coreysmccall/WeddingLEDBracelet/hardware/Bracelet/BOM_WeddingLEDBracelet_R3.csv

No. | Quantity | Comment | Designator | Value | Manufacturer Part | Manufacturer | Supplier Part | Supplier
1 | 1 | MY-2450-03 | BAT1 |  | MY-2450-03 | MYOUNG(美阳) | C2988622 | LCSC
2 | 1 | 10uF | C2 | 10uF | TAJA106K016RNJ | Kyocera AVX | C7171 | LCSC
3 | 8 | 4.7uF | C5,C6,C7,C8,C9,C10,C11,C12 | 4.7uF | CL10A475KO8NNNC | SAMSUNG(三星) | C19666 | LCSC
4 | 3 | 100nF | C13,C14,C15 | 100nF | CC0603KRX7R9BB104 | YAGEO(国巨) | C14663 | LCSC
5 | 6 | XL-2012SURC-FJ | LED1,LED2,LED3,LED4,LED5,LED6 |  | XL-2012SURC-FJ | XINGLIGHT(成兴光) | C7371909 | LCSC
6 | 2 | XL-2012UYC-FJ | LED7,LED8 |  | XL-2012UYC-FJ | XINGLIGHT(成兴光) | C7371908 | LCSC
7 | 8 | WNM2021-3/TR | Q1,Q2,Q3,Q4,Q5,Q6,Q7,Q8 |  | WNM2021-3/TR | WILLSEMI(韦尔) | C239556 | LCSC
8 | 2 | 10kΩ | R1,R2 | 10kΩ | 0603WAF1002T5E | UNI-ROYAL(厚声) | C25804 | LCSC
9 | 8 | 150Ω | R3,R6,R9,R12,R15,R18,R21,R24 | 150Ω | 0603WAF1500T5E | UNI-ROYAL(厚声) | C22808 | LCSC
10 | 1 | 100kΩ | R26 | 100kΩ | 0603WAF1003T5E | UNI-ROYAL(厚声) | C25803 | LCSC
11 | 8 | 100kΩ | R36,R37,R38,R39,R40,R41,R42,R43 | 100kΩ | 0402WGF1003TCE | UNI-ROYAL(厚声) | C25741 | LCSC
12 | 8 | 100Ω | R44,R45,R46,R47,R48,R49,R50,R51 | 100Ω | 0402WGF1000TCE | UNI-ROYAL(厚声) | C25076 | LCSC
13 | 1 | ATTINY816-MNR | U1 |  | ATTINY816-MNR | MICROCHIP(美国微芯) | C2052778 | LCSC
14 | 1 | ADXL345BCCZ-RL7 | U2 |  | ADXL345BCCZ-RL7 | ADI(亚德诺) | C9667 | LCSC
15 | 2 | FPC-1.0FX-16PWCR-H20 | U3,U4 |  | FPC-1.0FX-16PWCR-H20 | XUNPU(讯普) | C19269359 | LCSC
16 | 1 | bracelet_fingers | U5
17 | 1 | touch_heart | U6
18 | 3 | TP_1P | U8,U9,U10
