coreysmccall/WeddingLEDBracelet/PowerTests.md

# Power Tests
Tests related to power consumption using a cheap CR2450 battery ([EEMB from Amazon](https://a.co/d/5ZDkXNy)). A few batteries were tested with varying capacities between 80-100%.

## Max Current Stress Test
This test measures the maximum current stress by running [TestLEDMaxCurrent.ino](firmware/TestLEDMaxCurrent/TestLEDMaxCurrent.ino) in step mode, which turns the LEDs on one at a time in 200 ms steps until they are all on.

Using a 3.0 V bench supply, the max current drawn is ~53 mA. This aligns with the expected consumption of:

$$
(8 \times LED) \times \frac{(3V_{\text{supply}} - 2.0V_{\text{LED forward}})}{150\Omega} + (1mA_{\text{ATTINY816 @ 1MHz}}) \approx 54mA
$$

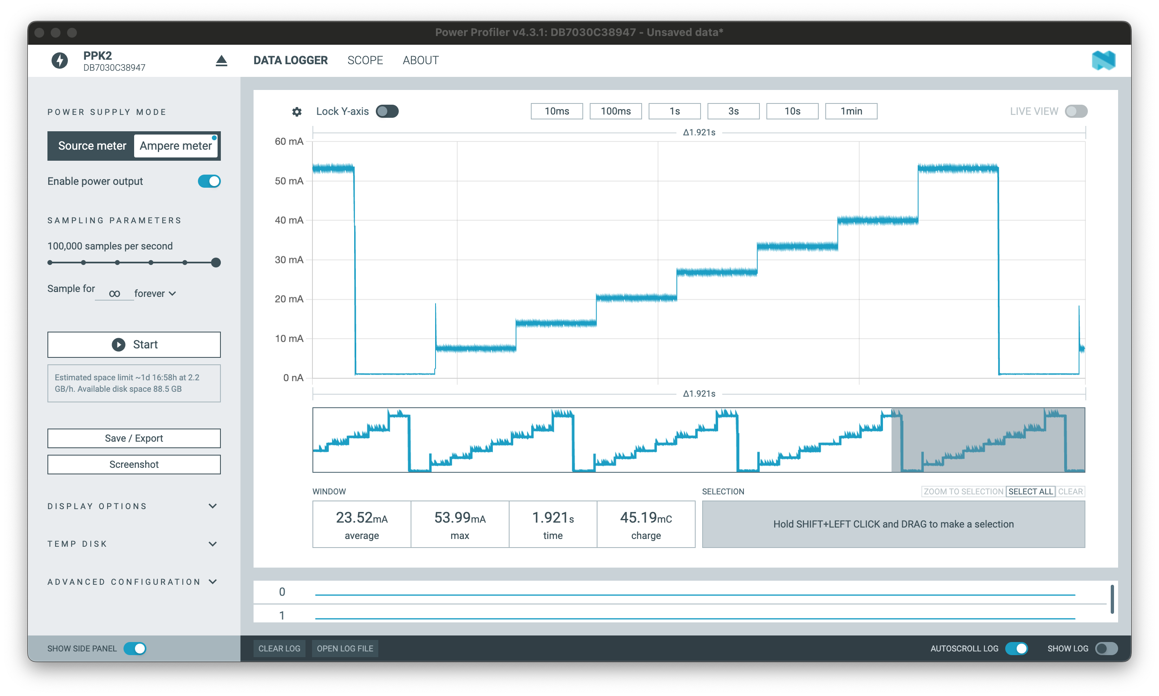
[picture p3: images/tests/PSU_LEDCurrentStep_I.png]
PSU_LEDCurrentStep_I


Using the battery, it is able to source around ~38 mA at the same maximum step, resulting in a voltage drop of about 300 mV to ~2.7 V (~8 Ω ESR):

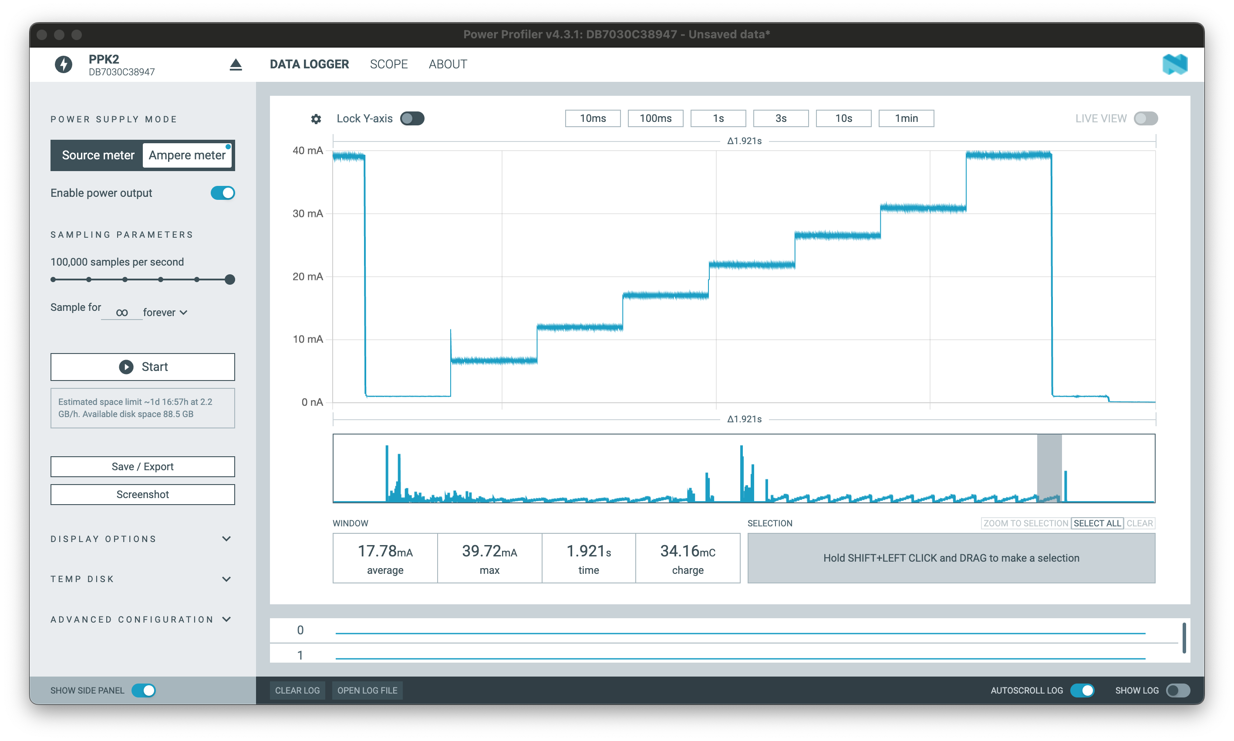
[picture p4: images/tests/EEMB_LEDCurrentStep_I.png]
EEMB_LEDCurrentStep_I
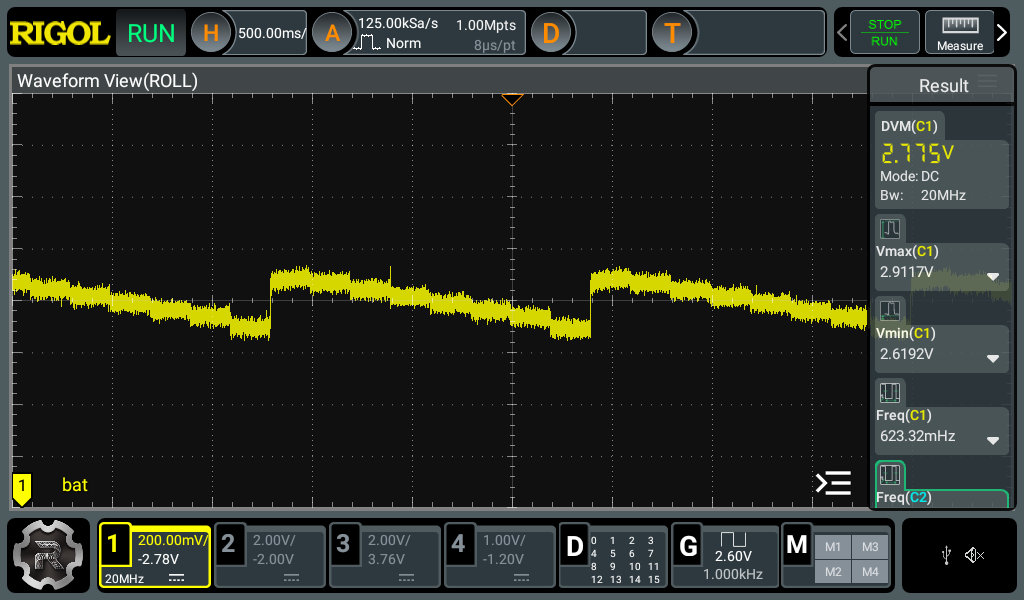
[picture p5: images/tests/EEMB_LEDCurrentStep_V.png]
EEMB_LEDCurrentStep_V
&nbsp;&nbsp;&nbsp;&nbsp;&nbsp;&nbsp;&nbsp;&nbsp;&nbsp;&nbsp;&nbsp;&nbsp;&nbsp;&nbsp;&nbsp;&nbsp;&nbsp;&nbsp;

The battery is also able to sustain >30 mA DC drain for several minutes with only slowly decreasing voltage plateauing around ~2.5V (~17 Ω ESR) after a few minutes. This test was run from [TestLEDMaxCurrent.ino](firmware/TestLEDMaxCurrent/TestLEDMaxCurrent.ino) (not in step mode):

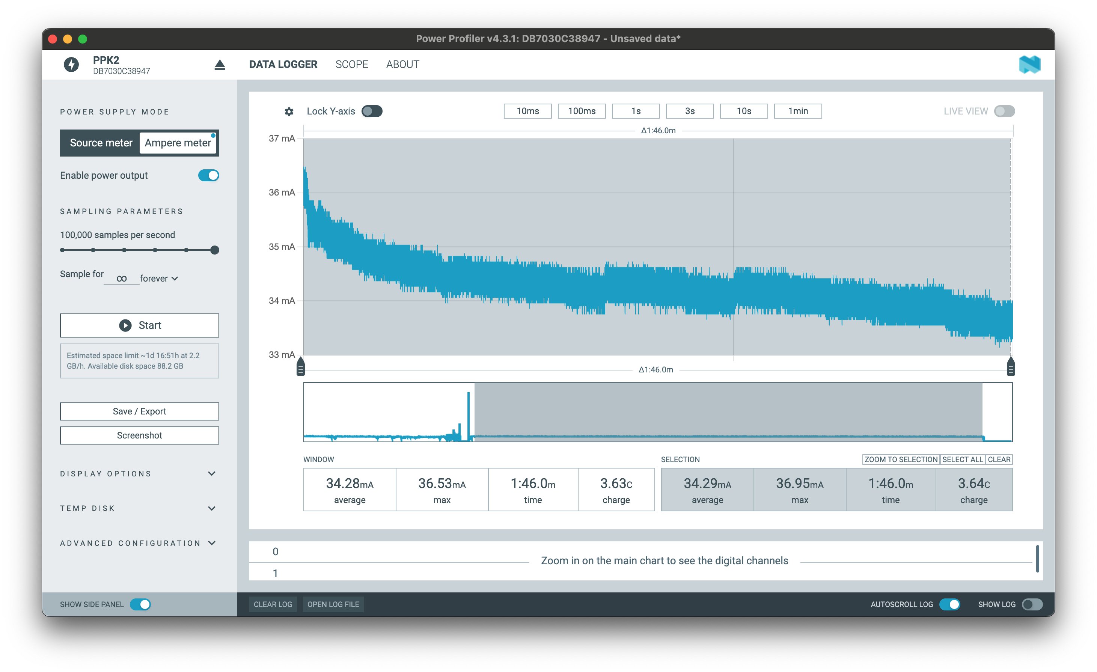
[picture p6: images/tests/EEMB_drain_I.png]
EEMB_drain_I
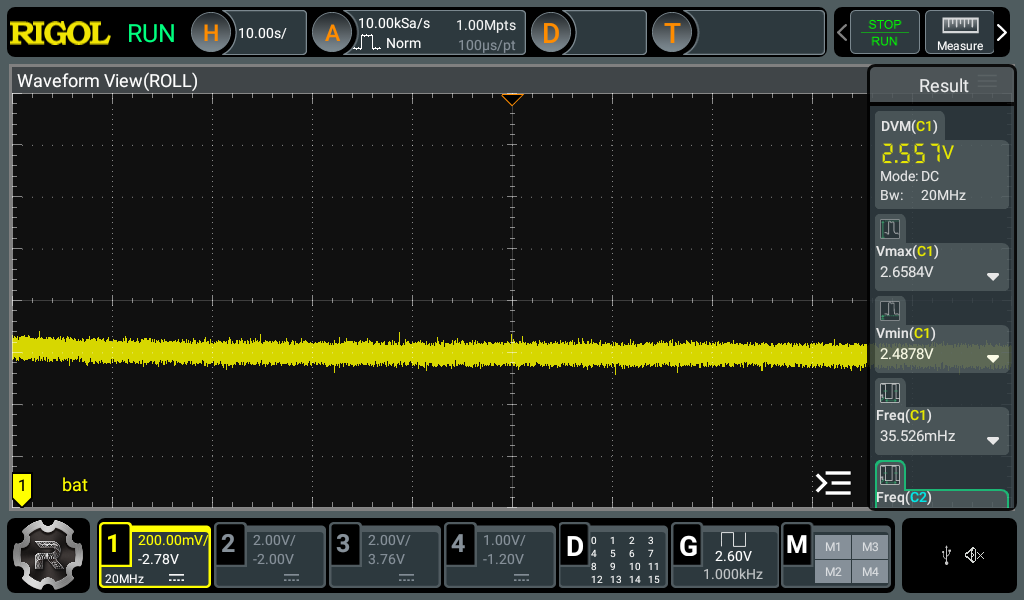
[picture p7: images/tests/EEMB_drain_V.png]
EEMB_drain_V
&nbsp;&nbsp;&nbsp;&nbsp;&nbsp;&nbsp;&nbsp;&nbsp;&nbsp;&nbsp;&nbsp;&nbsp;&nbsp;&nbsp;&nbsp;&nbsp;&nbsp;&nbsp;

## PWM Pattern Operation
The Twinkle pattern in [TestPWMs.ino](firmware/TestPWMs/TestPWMs.ino) is a good indication of a typical LED pattern with reasonable brightness (shown in the [README](README.md) gif). This pattern randomly adjusts LED brightness via PWM without any attention to phase alignment. The individual duty cycles are low, but occasionally both PWM timers align and all 8 LEDs briefly draw max current for up to the max duty cycle (~16% @ ~500 Hz = ~310 µs). 

On the bench supply, you can see the occasional max draw of ~53 mA when this occurs, agreeing with the stress test above.

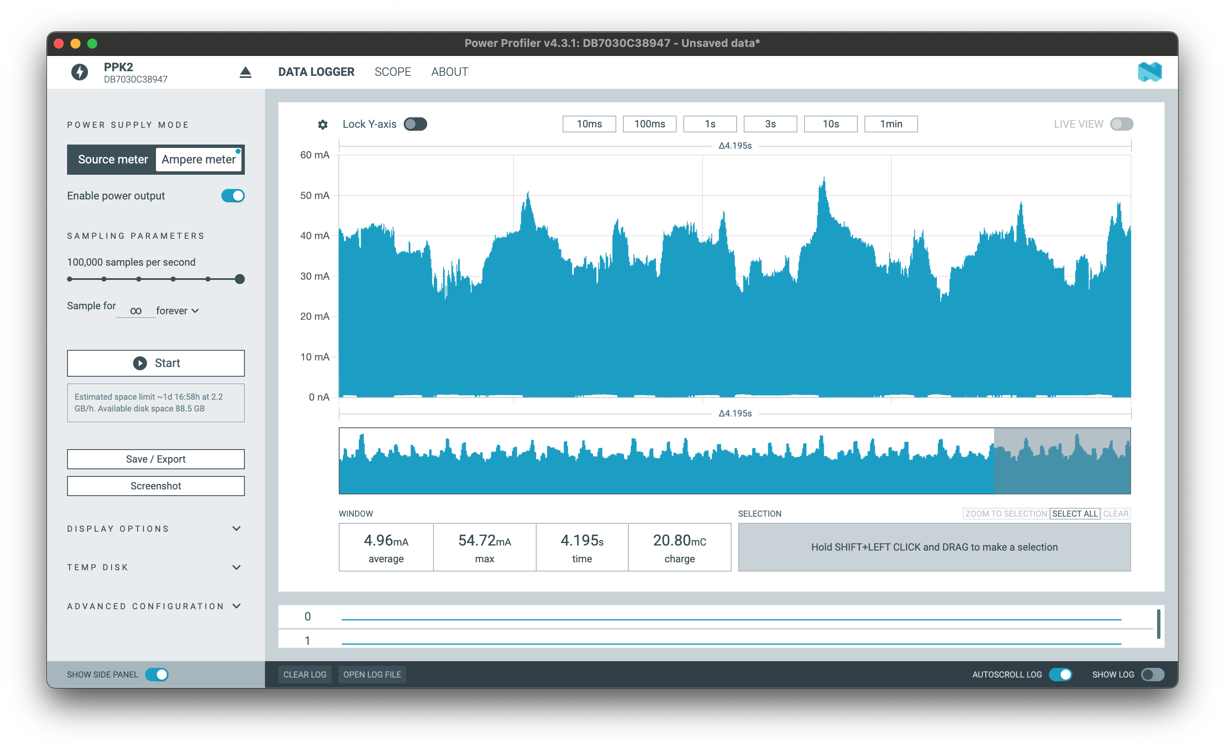
[picture p8: images/tests/PSU_testPWMs_I.png]
PSU_testPWMs_I


On the battery, the consumption also agrees with the stress test, maxing out at ~35 mA:

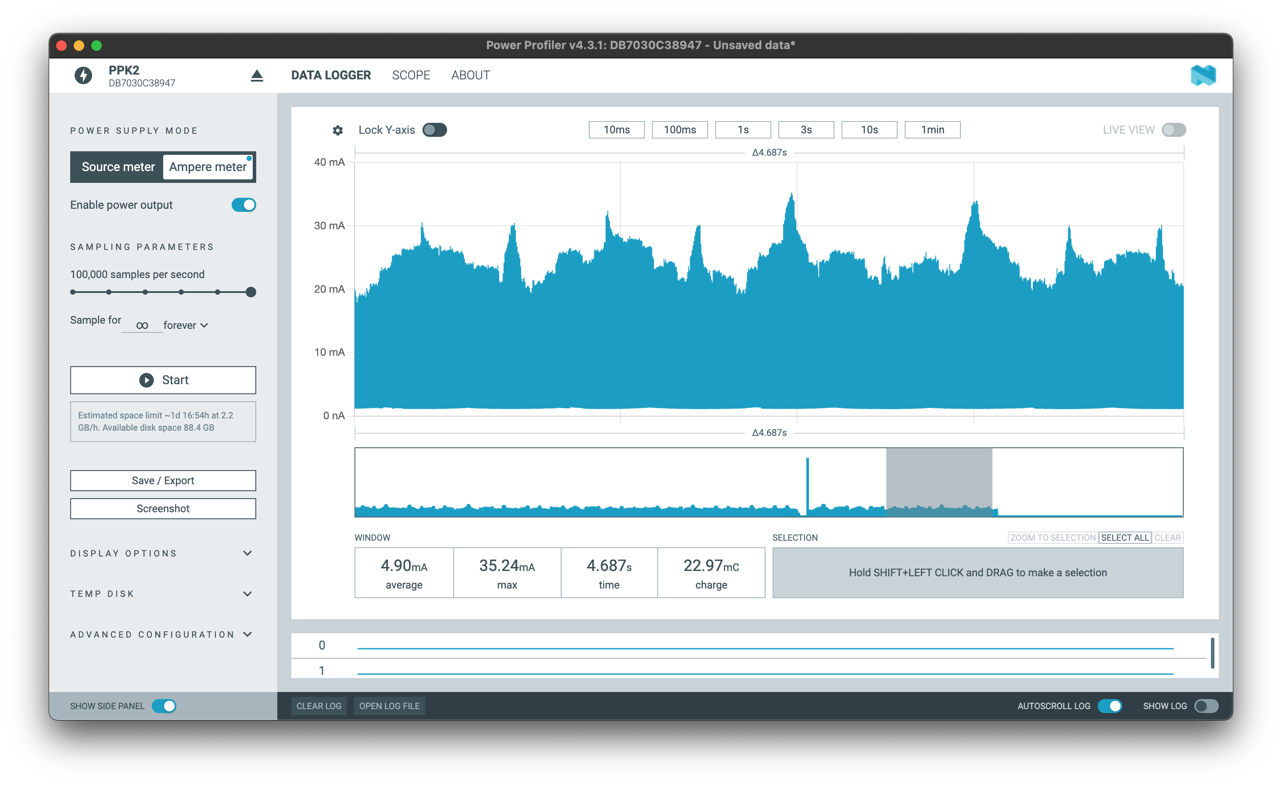
[picture p9: images/tests/EEMB_testPWMs_I.png]
EEMB_testPWMs_I
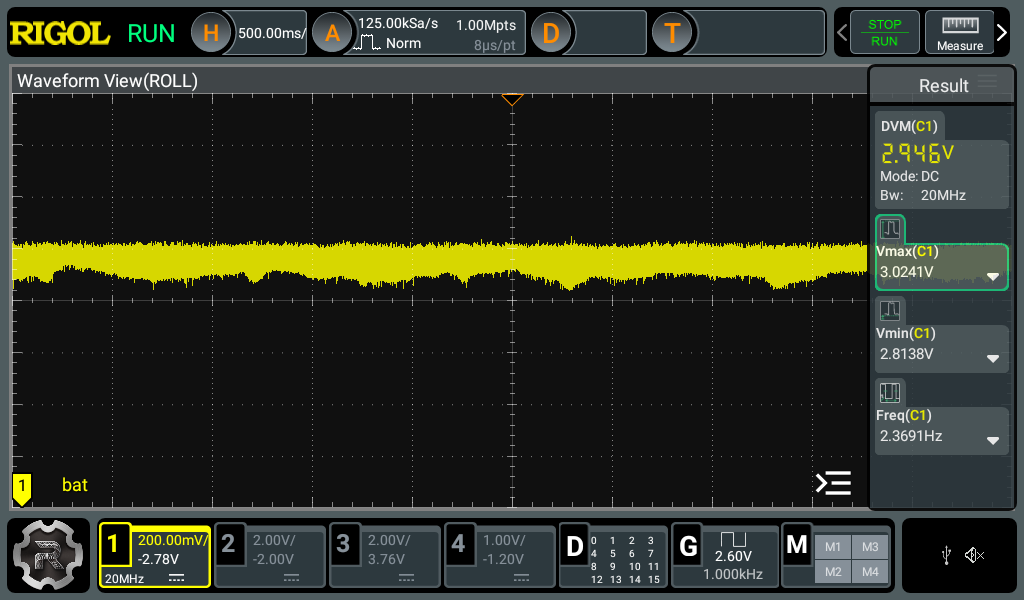
[picture p10: images/tests/EEMB_testPWMs_V.png]
EEMB_testPWMs_V
&nbsp;&nbsp;&nbsp;&nbsp;&nbsp;&nbsp;&nbsp;&nbsp;&nbsp;&nbsp;&nbsp;&nbsp;&nbsp;&nbsp;&nbsp;&nbsp;&nbsp;&nbsp;

Unlike the DC drain test, the battery voltage can now be easily maintained at its nominal 3V, as the average current is much lower and it only needs to recover from short pulses—the worst being when both PWM timers overlap like the one below:

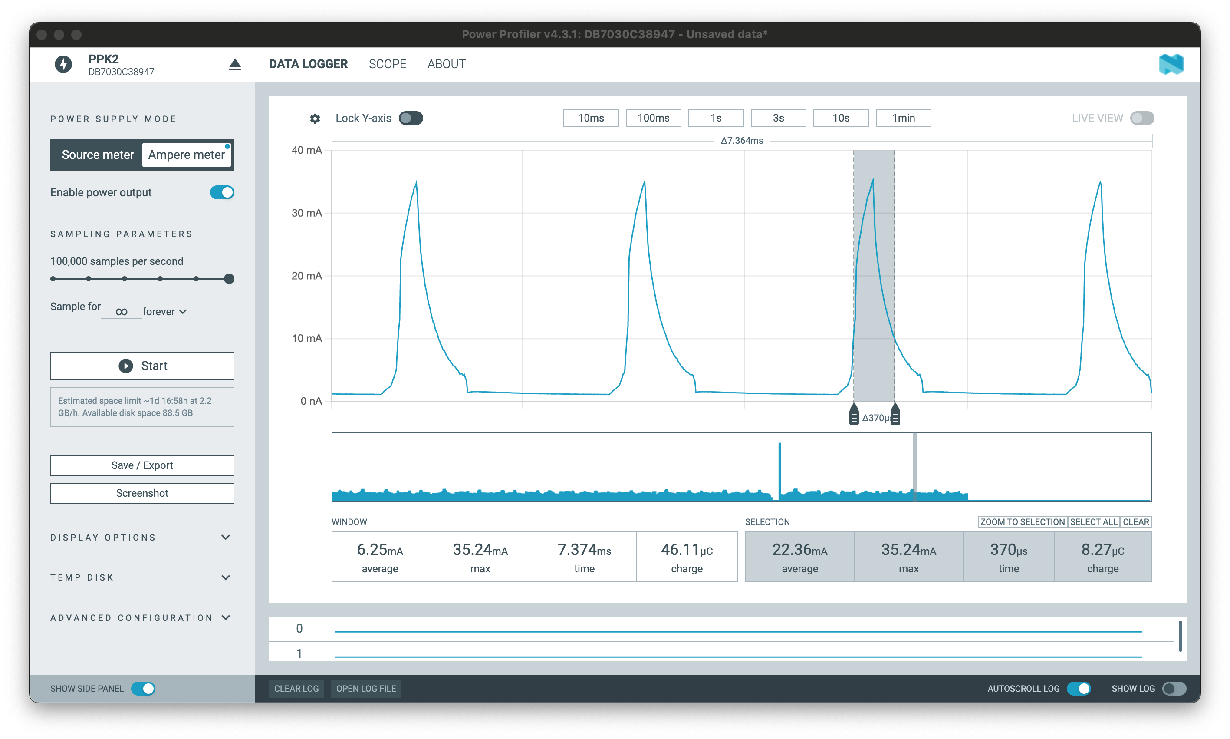
[picture p11: images/tests/EEMB_testPWMs_I_zoom.png]
EEMB_testPWMs_I_zoom


There are [4.7 µF capacitors at each of the 8x LEDs](hardware/Bracelet/Sch_WeddingLEDBracelet_R3.pdf) that may help to minimize max voltage droop of short PWM pulses as the battery ESR increases with depletion. If ESR becomes an issue, faster PWM frequencies (> 500 Hz) could be tried to better utilize these capacitors during strenuous patterns. 

## Non-LED Power Consumption
The LEDs are the main consumers of current. However, the MCU, accelerometer, and touch sensor also consume current. This can be measured from [TestHardware.ino](firmware/TestHardware/TestHardware.ino) before the LED pattern begins. This current is <1 mA with periodic spikes to 1.5 mA from the PTC (MCU touch sensor controller).

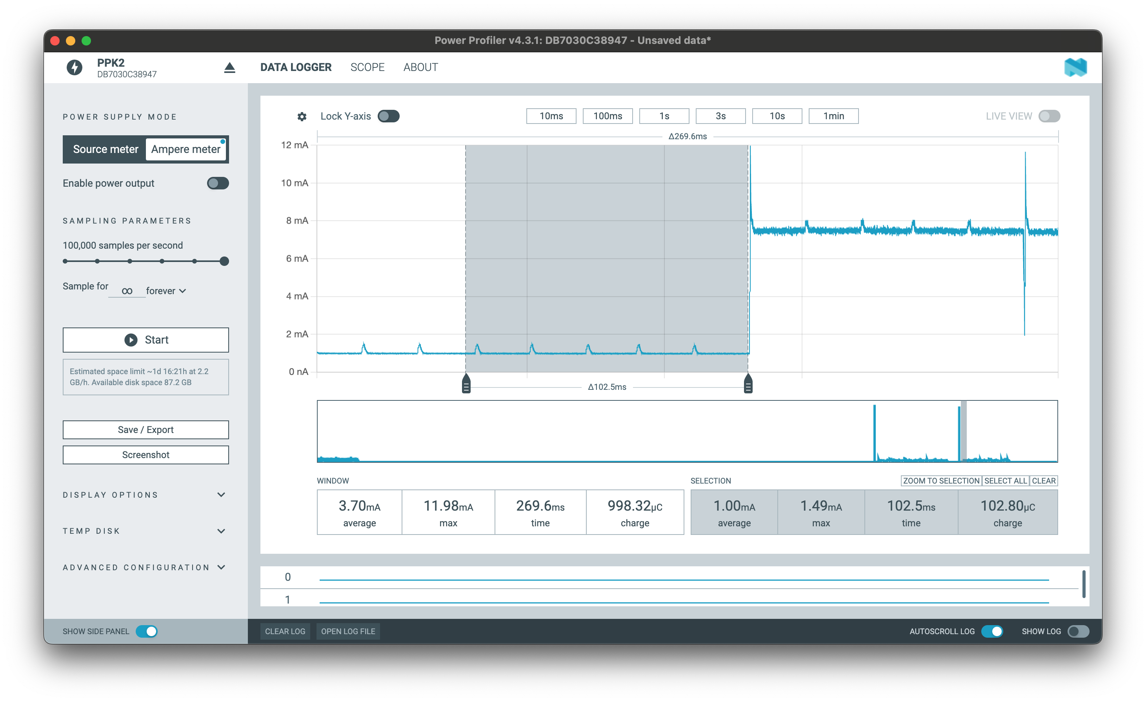
[picture p12: images/tests/EEMB_TestHardware_I.png]
EEMB_TestHardware_I


## Battery life
The stress test was continued for 2 hours, resulting in a voltage of 2.37 V at 25 mA (~25 Ω ESR). Even at absolute maximum power stress, the battery should last beyond 2 hours, likely much much longer with PWM patterns. 

## Current Draw Guidelines
- It seems safe to draw the maximum current of the circuit, even for multiple hours at a time. ESR increases, but the test battery was still able to deliver 25mA after 2 hours, maintaining a voltage well above brownout. 
- There is probably no practical benefit from power-optimizing the accelerometer, PWM phase offset, or MCU power states (at least at 1 MHz MCU clock). Battery life and max current is already good enough for at least 2 hours.
