coreysmccall/WeddingLEDBracelet/hardware/Bracelet/Sch_WeddingLEDBracelet_R3.pdf

# LED Drivers (~7.3mA nominal)

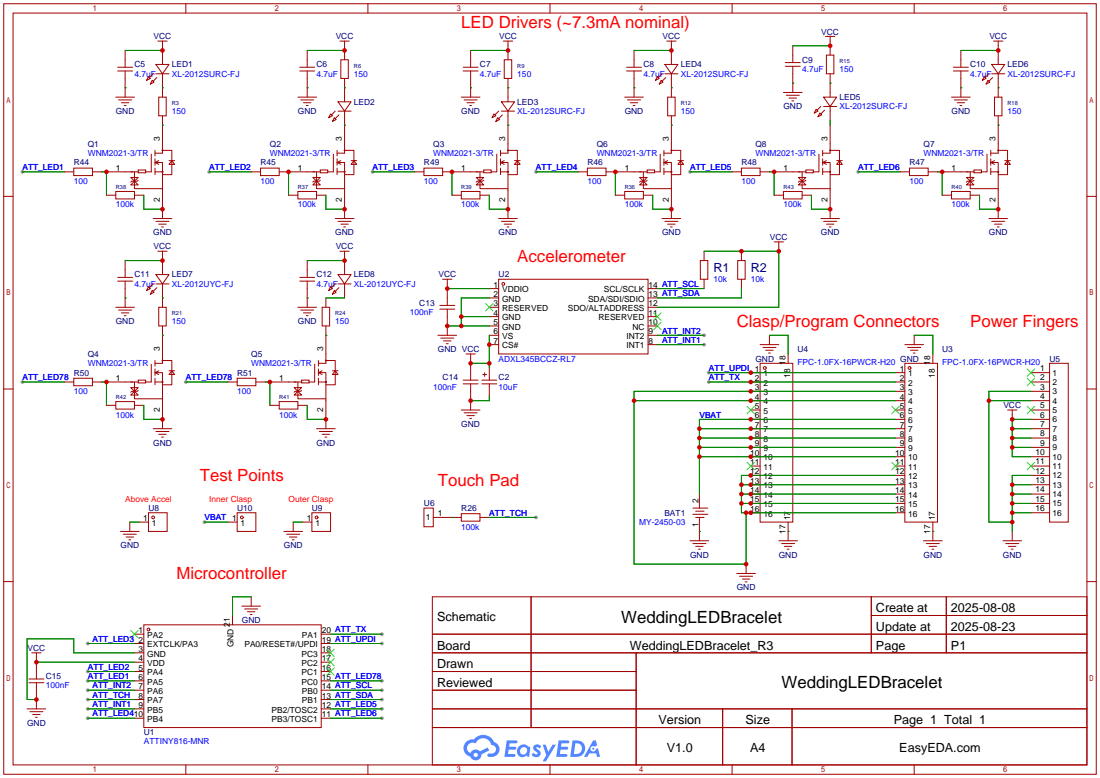
[picture p13: page 1]

NC 10 RESERVED 11 SDO/ALTADDRESS 12 SDA/SDI/SDIO 13 SCL/SCLK 14

Schematic | WeddingLEDBracelet | Create at | 2025-08-08

Update at | 2025-08-23

Board | WeddingLEDBracelet_R3 | Page | P1
Drawn | | WeddingLEDBracelet
Reviewed

Version | Size | Page 1 Total 1
V1.0 | A4 | EasyEDA.com
