coreysmccall/WeddingLEDBracelet/hardware/Programmer/Sch_WeddingLEDBracelet_Programmer_R1.pdf

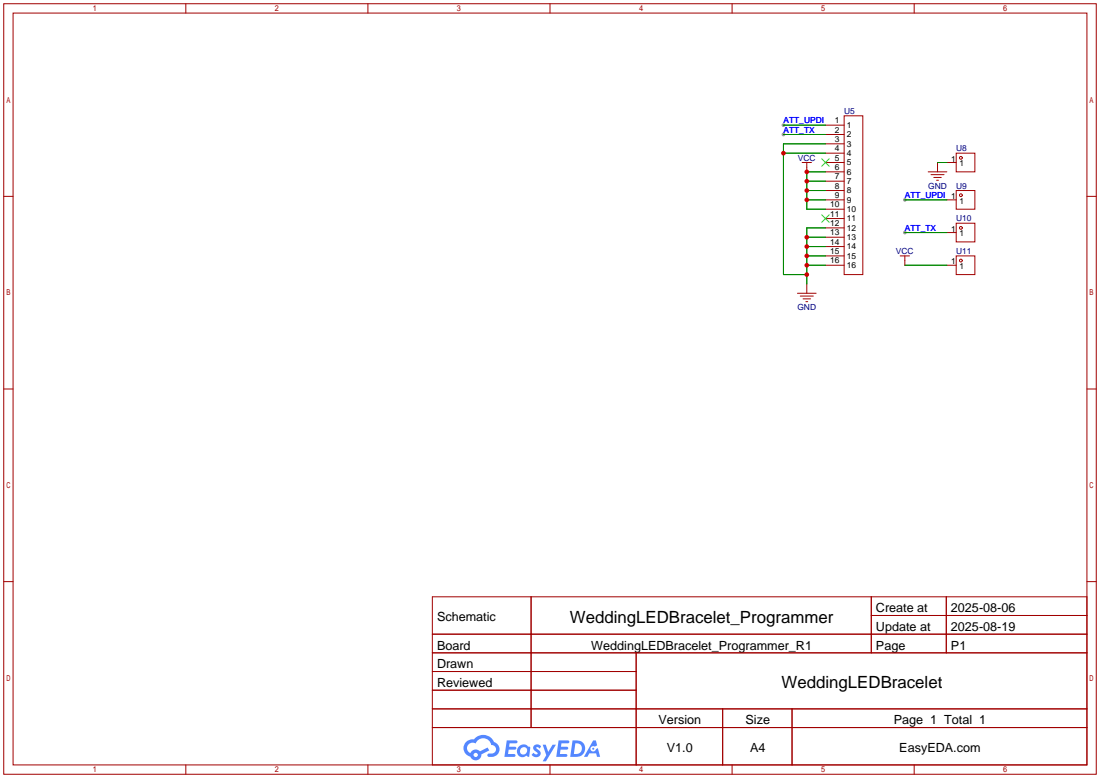
[picture p14: page 1]

Schematic | WeddingLEDBracelet_Programmer | Create at | 2025-08-06

Update at | 2025-08-19

Board | WeddingLEDBracelet_Programmer_R1 | Page | P1
Drawn | | WeddingLEDBracelet
Reviewed

Version | Size | Page 1 Total 1
V1.0 | A4 | EasyEDA.com
