coreysmccall/WeddingLEDBracelet/hardware/Bracelet/Layout_WeddingLEDBracelet_R3.pdf

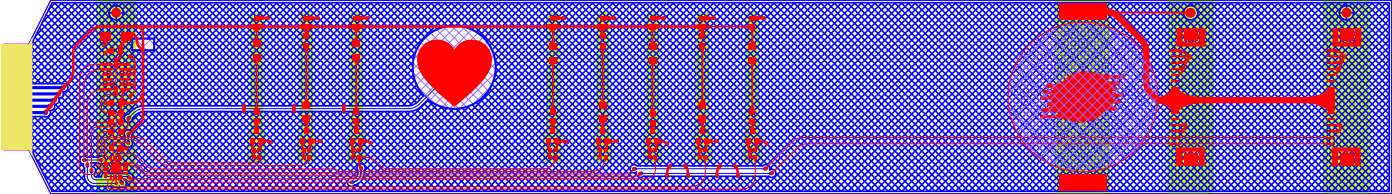
[picture p15: page 1]

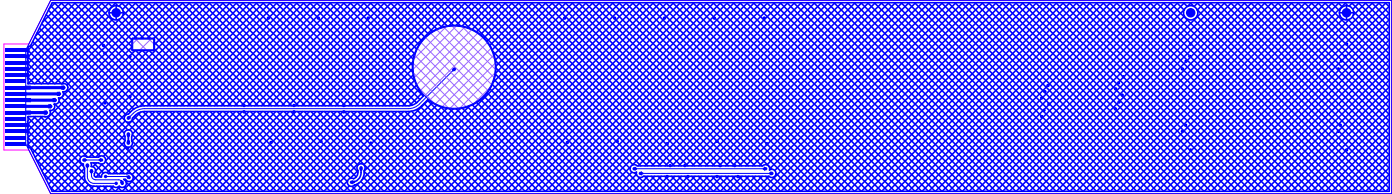
[picture p16: page 3]
