coreysmccall/WeddingLEDBracelet/(commit log)

2025-08-20 added ADXL interrupt functions
2025-08-20 pin names
2025-08-21 heart touch sensor test
2025-08-22 power test
2025-08-22 power test doc
2025-08-23 longer power measurements
2025-08-23 schematic cleanup
2025-08-23 note to use alt I2C address
2025-08-24 simplified PWM setup
2025-08-25 fixed PWMs further, added demo fw
    [Corey.ino, TestHardware.ino, TestPWMs.ino]
